LEECHOONGHO/UnitreeG1-OAK-D-W-Camera-Mount/README.md

# UnitreeG1-OAK-D-W-Camera-Mount

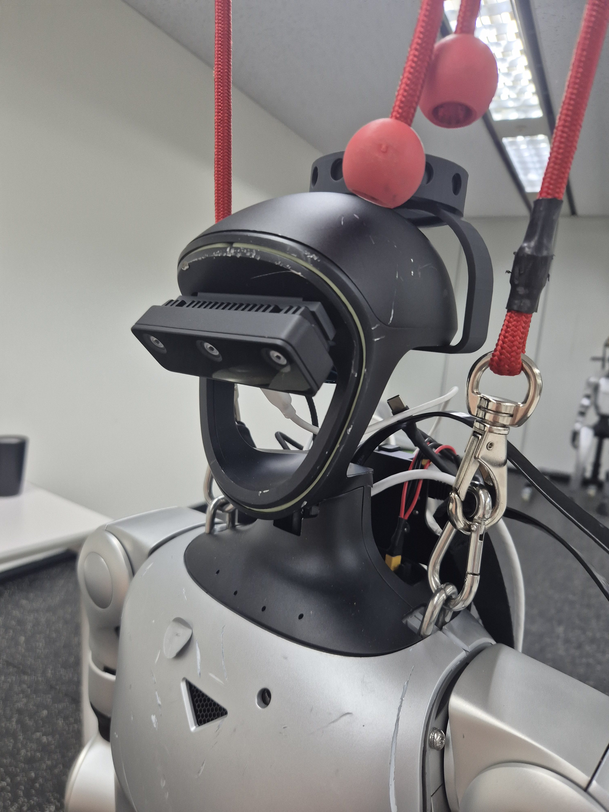
[picture p1: assets/oak-d-w mount.jpg]
Mount Image


This guide covers the design and installation of an OAK-D-W-97 camera mount that replaces the Realsense camera on the Unitree G1 robot.  

---
For the complete workflow—from design to installation—refer to the **Lotte Innovate** document **“OAK-D-W Mount 3D Printing Guide.pdf.”**  

If you prefer to outsource the 3D printing, you can contact a professional 3D‑printing service. 

In my case, I sent each part’s required number of brass inserts, the corresponding STL files, and a **Brass Insert Guide – {PartName}.pdf** as a package to the vendor.  

If you’d like to modify the design quickly, you can upload the STL files to **Tinkercad** and edit them there.

### Camera
OAK-D W (sensor option : ov9782)
https://docs.luxonis.com/hardware/products/OAK-D%20W
