LEECHOONGHO/UnitreeG1-OAK-D-W-Camera-Mount/[Lotte Innovate] OAK-D-W Mount 3D Printing Brass Insert Guide - Main Parts.pdf

# OAK-D-W-Mount Main Parts Brass Insert Guide

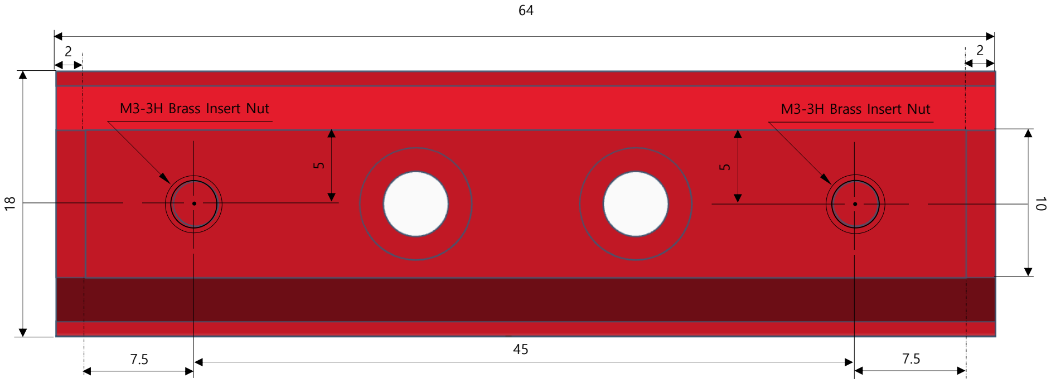
[picture p2: figure]
M3-3H Brass Insert Nut

## Rear View
