LEECHOONGHO/UnitreeG1-OAK-D-W-Camera-Mount/OAK-D-W-Mount-Main-Parts.stl

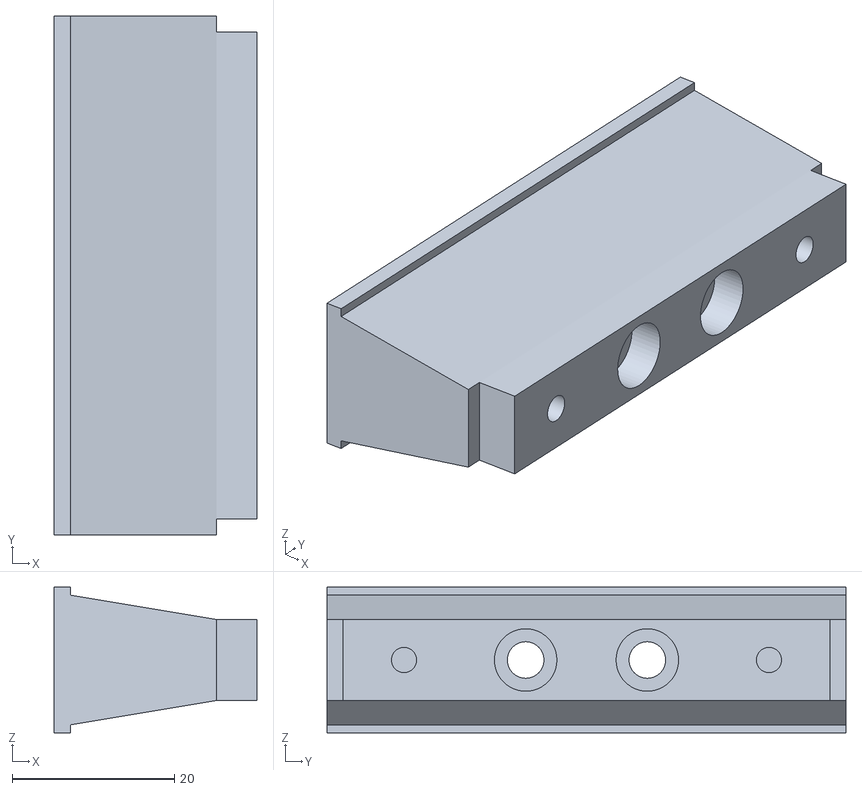
[picture p3: CAD file, 2026-07-15]
OAK-D-W-Mount-Main-Parts.stl
25.0 x 64.0 x 18.0
