LEECHOONGHO/UnitreeG1-OAK-D-W-Camera-Mount/OAK-D-W-Mount-Front-Parts.stl

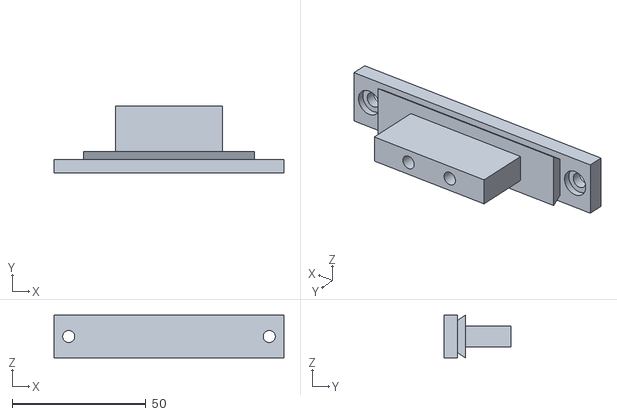
[picture p4: CAD file, 2026-07-15]
OAK-D-W-Mount-Front-Parts.stl
86.0 x 25.0 x 16.0
