LEECHOONGHO/UnitreeG1-OAK-D-W-Camera-Mount/[Lotte Innovate] OAK-D-W Mount 3D Printing Brass Insert Guide - Front Parts.pdf

# OAK-D-W-Mount Front Parts Brass Insert Guide

## Front View

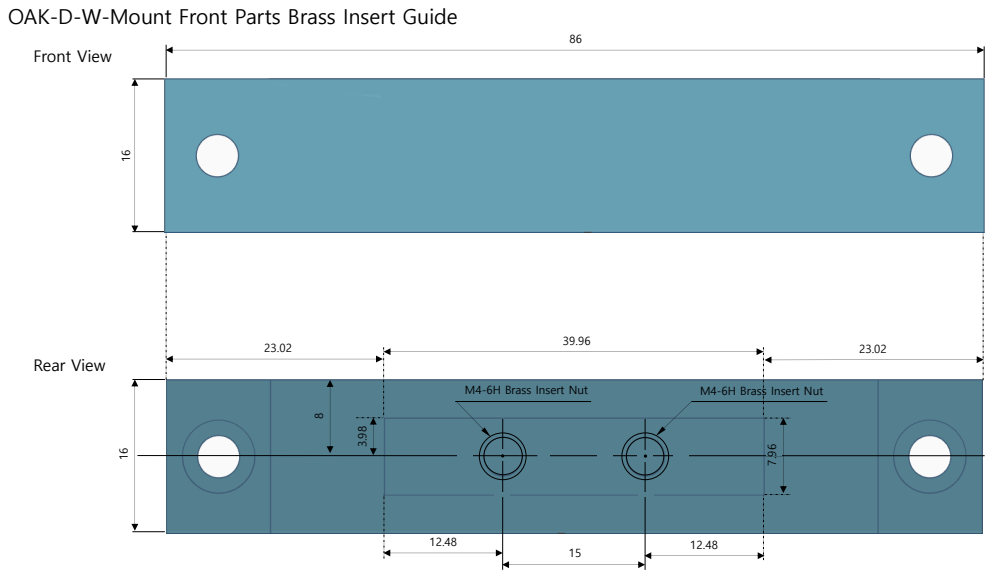
[picture p5: page 1]
Rear View

M4-6H Brass Insert Nut
